buhsdv/AD9850_DDS/README.md

# Welcome to the AD9850 DDS generator

Hi! This project is used to build a **DDS frequency generator** out of a **Arduino yun** and a **AD9850** frequency module.

# Arduino program
The arduino program has everything in it to use it right away.

# Remote program

## Java version
The build version need JRE 17. If you want to use an other JRE, you can build the source with the JDK you want.
