buhsdv/AD9850_DDS/Dokumentation/01_VP_DDS_KrauseFischer_THOWL_Praesentation.pdf

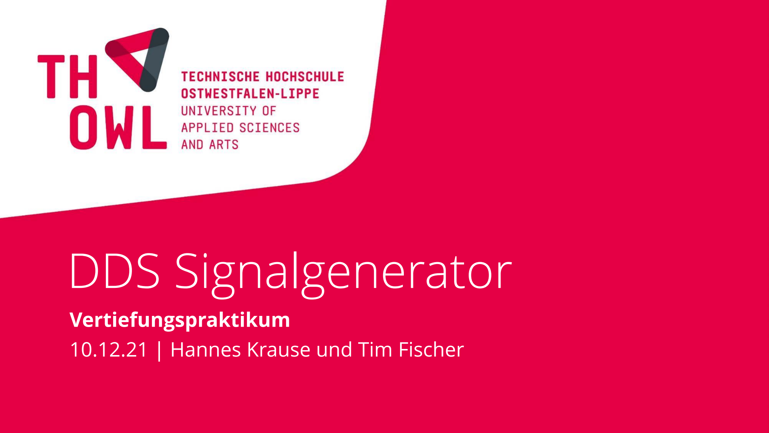
[picture p38: page 1]

# DDS Signalgenerator

Vertiefungspraktikum
10.12.21 | Hannes Krause und Tim Fischer

Datum | Name

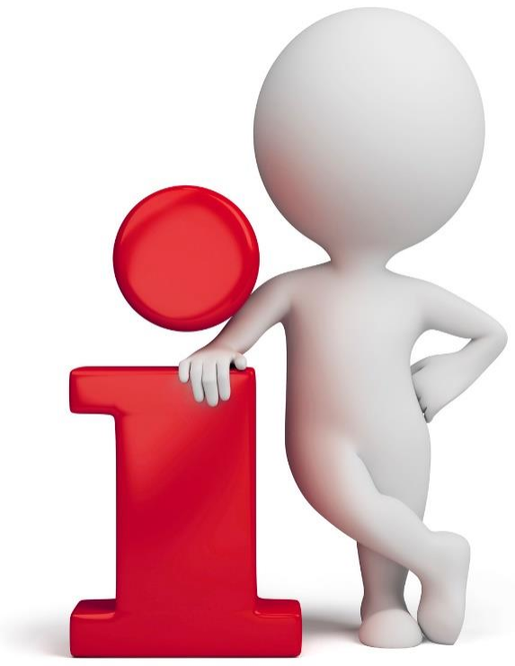
[picture p39: figure]

◼ Aufgabenstellung & Herausforderungen ◼ Hintergrundwissen
◼ Hardware
◼ Aufbau
◼ Arduino Programm
◼ Remote Programm
◼ Vorführung
◼ Messung und Fehleranalyse ◼ Ausblick
◼ Quellen

# Überblick

10.12.21 | Hannes Krause und Tim Fischer

# Aufgabenstellung

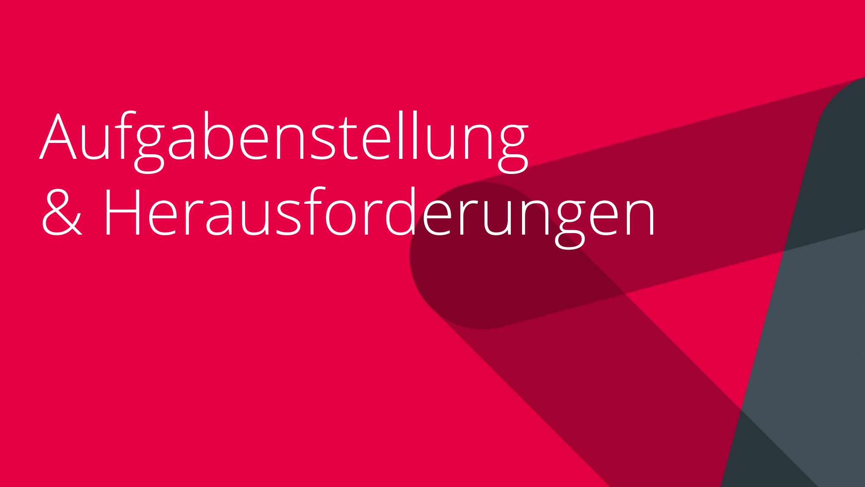
[picture p40: page 3]

# & Herausforderungen

# Aufgabenstellung

◼ Softwareentwurf DDS-Generator

◼ Festfrequenz

◼ Lineares & logarithmisches Wobbeln

◼ Einstellung aller Frequenzen in 10Hz-Schritten

◼ Menü

◼ Fernsteuerung über PC

# Herausforderungen

◼ Display mit zwei Zeilen stellt hohe Anforderungen an Menü

◼ Begrenzte Eingabemöglichkeit (Rotary Encoder + 3 Taster)

◼ Anforderung von linearem und logarithmischem Frequenzlauf

# Hintergrundwissen

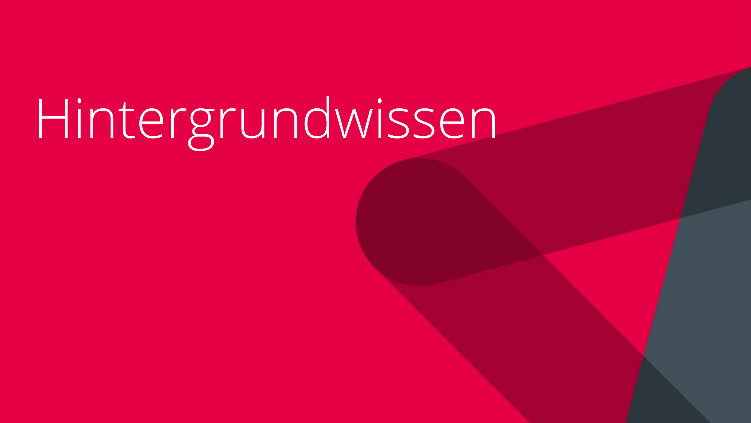
[picture p41: page 6]

# Was ist ein DDS-Generator?

◼ DDS = Direct Digital Synthesis/Direct Digital Synthesizer

◼ Verfahren zur Erzeugung analoger Wellenformen

◼ Digital erzeugtes, zeitveränderliches Signal mittels D/A-Wandler in analoge Ausgangsgröße umgewandelt

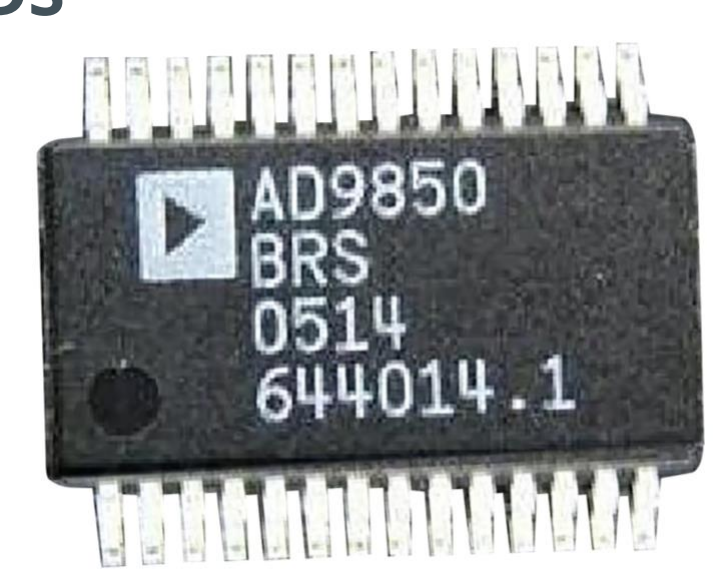
[picture p42: figure]

◼ DDS & D/A-Wandler auf einem Chip: Complete DDS

◼ Referenztakt & Steuerwort benötigt

# Was ist ein DDS-Generator?

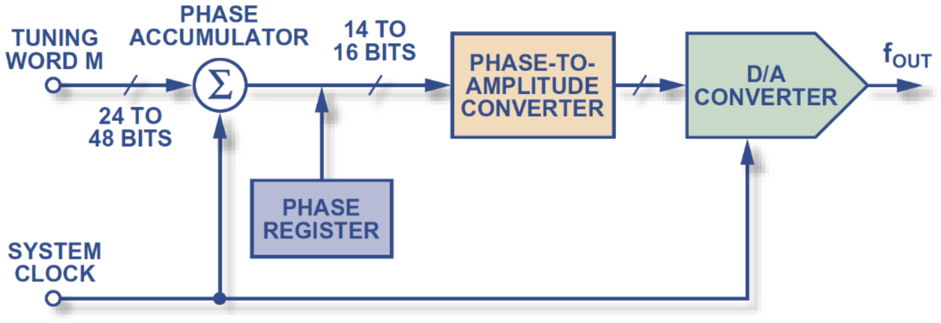
[picture p43: figure]

# Was ist ein DDS-Generator?

◼ Akkumulator addiert pro Taktzyklus Wert des Steuerworts auf aktuellen Akkumulator-Wert
◼ Bei Überlauf Rücksetzen auf Null

◼ →sägezahnförmiger Verlauf des Wertes

◼ →kann als diskretes Maß für Phasenwinkel eines Sinus betrachtet werden

# Was ist ein DDS-Generator?

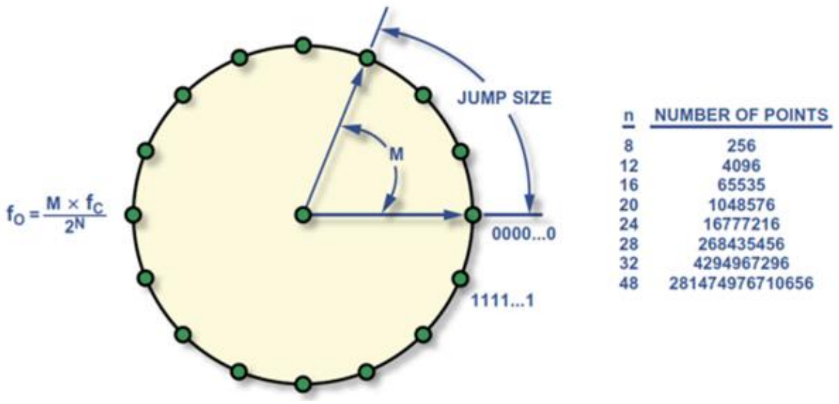
[picture p44: figure]

# Was ist ein DDS-Generator?

◼ fout =

M∗fc
2

n
◼ Nach Nyquist-Shannon gilt: fout,max =

fc
2
◼ tatsächliche Maximalfrequenz deutlich kleiner, da dann bessere Signalgüte & Weiterverarbeitung möglich

◼ Zuordnung von Funktionswerten zu Phasenwerten über Lookup-Table oder Algorithmen (z.B. CORDIC)

◼ Erzeugen des quasi-zeitkontinuierlichen , sinusförmigen Ausgangssignals durch den D/A-Wandler

# Was ist ein DDS-Generator?

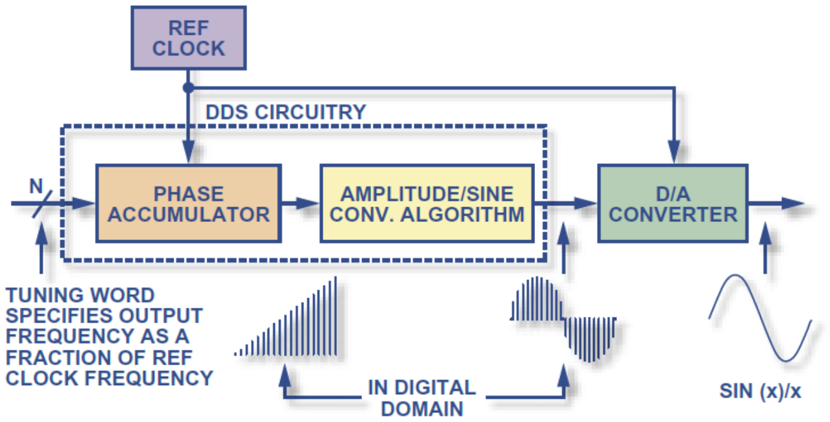
[picture p45: figure]

# Was ist ein DDS-Generator?

◼ Kompakte & kostengünstige Herstellung

◼ Vollst. digital programmierbar → simple Hardware

◼ Frequenzauflösung im Microhertz-Bereich

◼ Extrem schnelle, exakte Frequenzänderung

◼ Qualitativ hochwertiges Ausgangssignal mit großem Frequenzbereich

◼ Geringer Leistungsbedarf

# Frequenzlauf

◼ Auch Sweep, Chirp oder Wobbel genannt

◼ Wechselsignal konstanter Amplitude

◼ Frequenz ändert sich zeitlich periodisch zwischen Start- und Endwert
◼ Änderung in unterschiedlicher Form möglich

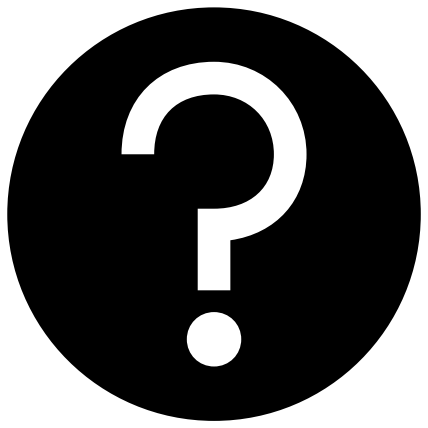
[picture p46: figure]
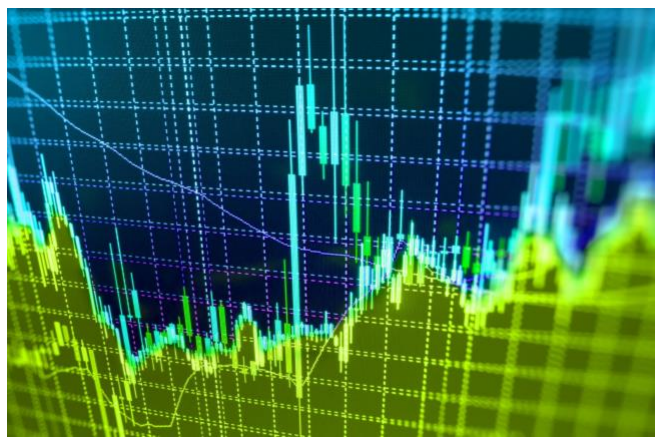
[picture p47: figure]
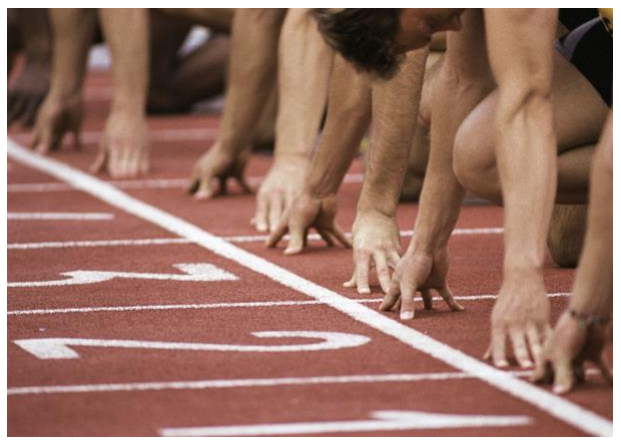
[picture p48: figure]

# Linearer Frequenzlauf

◼ Lineare Frequenzänderung vom Start- zum Endwert: f t = ct + f0
◼ Mit Frequenzänderung c:

c =

f1 − f0
T
◼ Integration der Frequenz liefert Phase: φ t = φ0 + 2π න

0

t
f τ dτ

◼ Zeitfunktion des linear gesweepten Signals:
x t = sin | φ t | = sin | φ0 + 2π

c
2

∗ t

2 + f0t

# Linearer Frequenzlauf

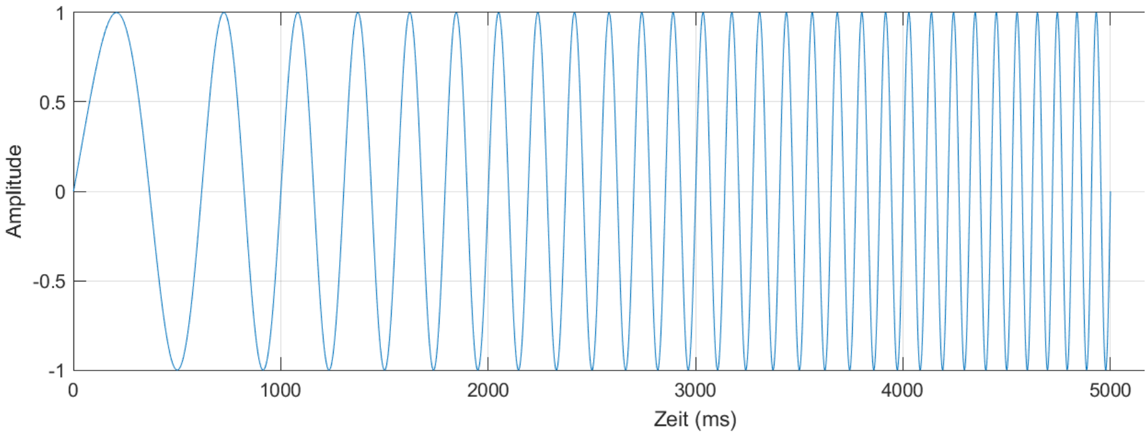
[picture p49: figure]

# Logarithmischer Frequenzlauf

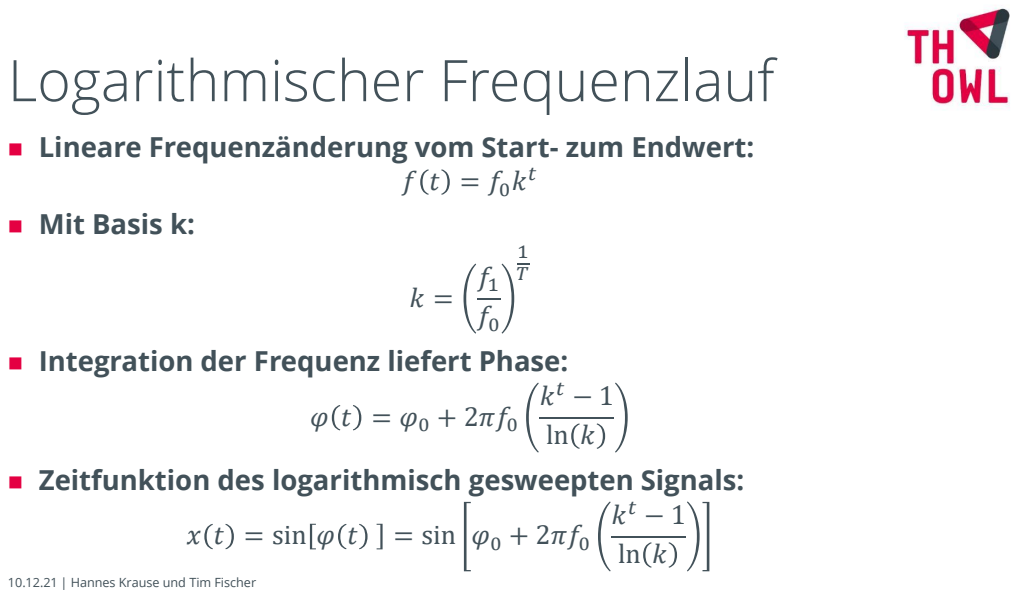
[picture p50: page 17]
◼ Mit Basis k:; x t = sin; = sin

◼ Lineare Frequenzänderung vom Start- zum Endwert:

◼ Integration der Frequenz liefert Phase:

◼ Zeitfunktion des logarithmisch gesweepten Signals:

# Logarithmischer Frequenzlauf

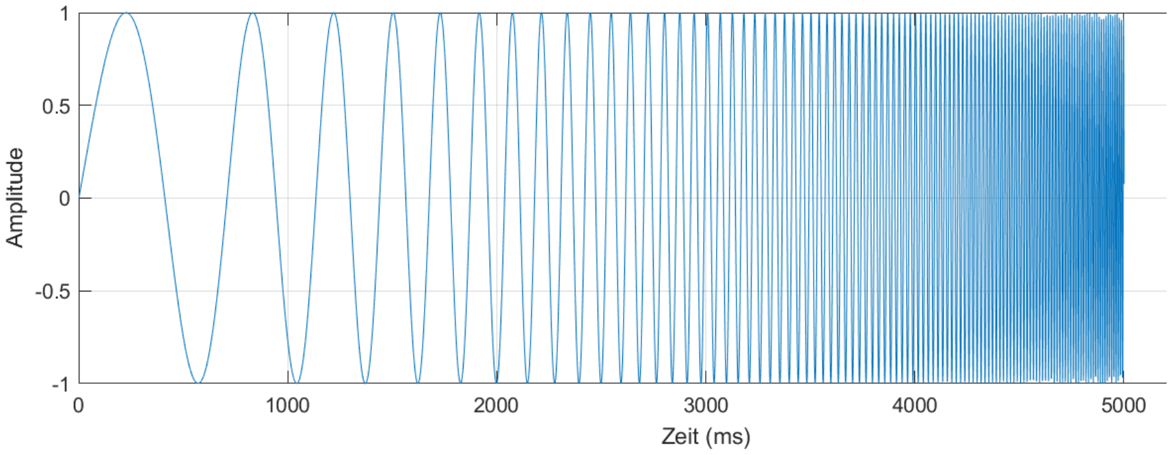
[picture p51: figure]

# Verwendete Hardware

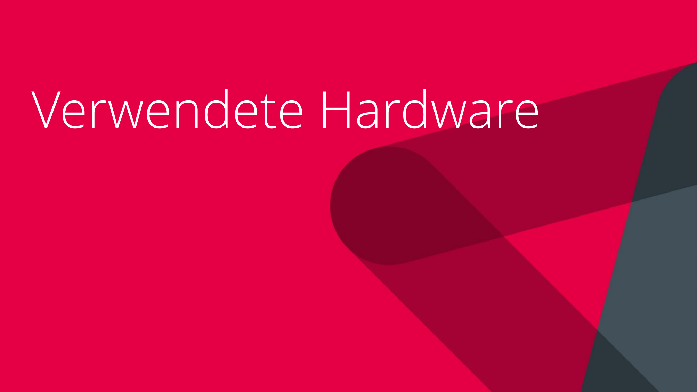
[picture p52: page 19]

# Arduino Yun

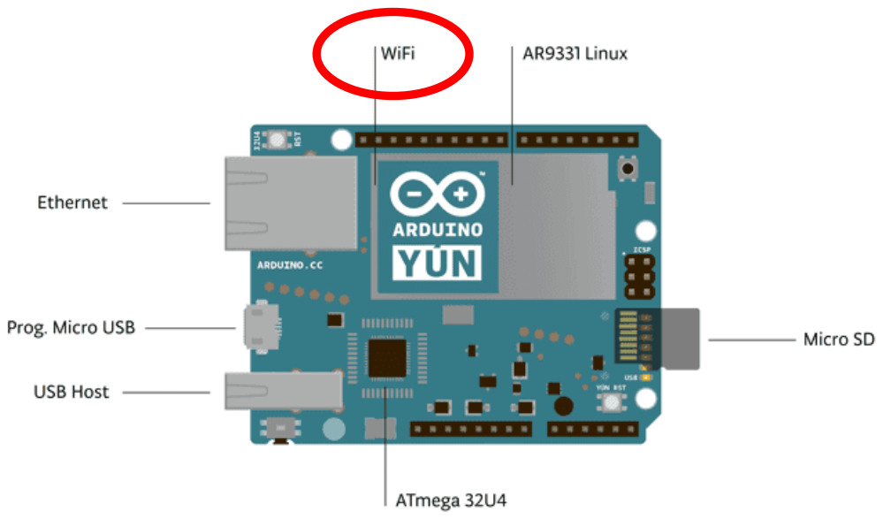
[picture p53: figure]

# Arduino Yun

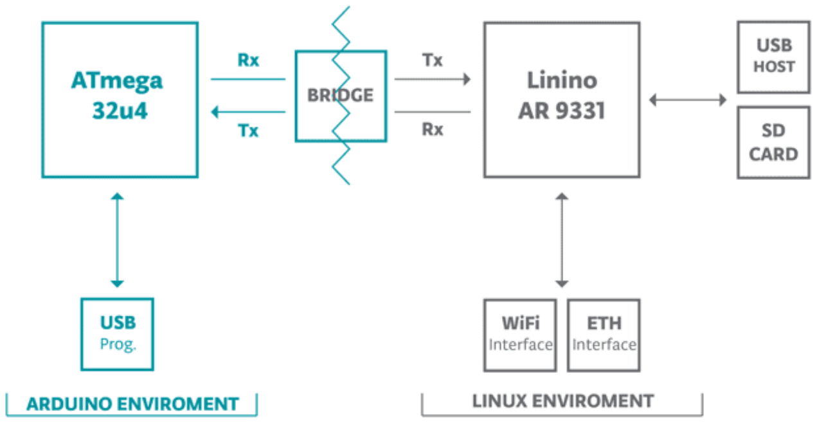
[picture p54: figure]

# ADS9850 (HC-SR08)

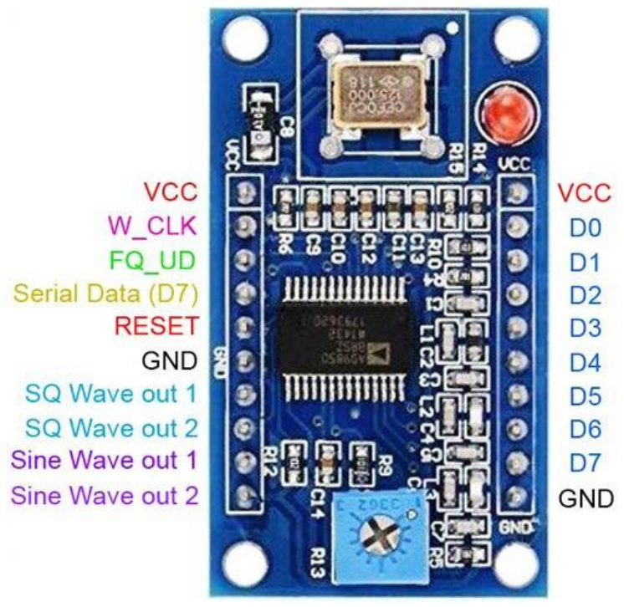
[picture p55: figure]

# ADS9850 (HC-SR08)

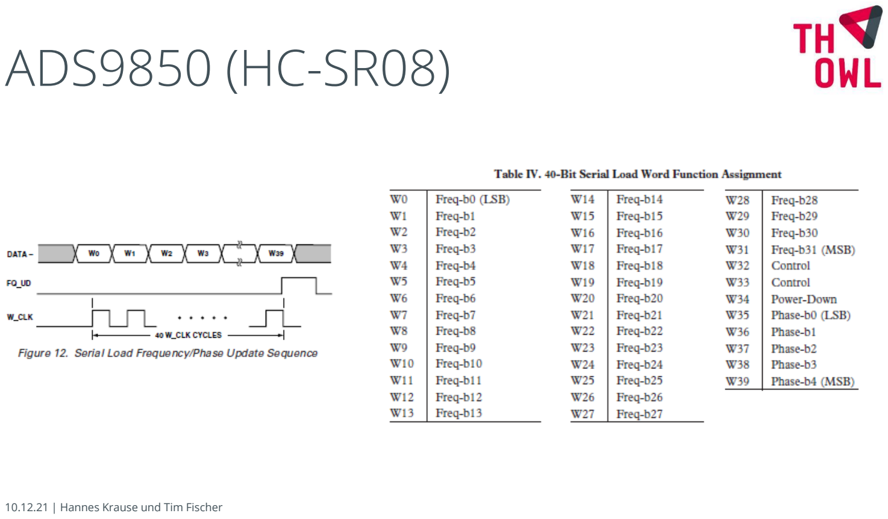
[picture p56: page 23]

# LCD mit HD44780-Controller

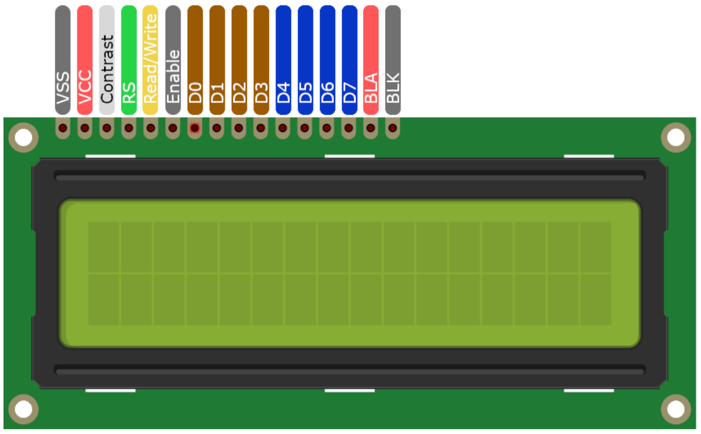
[picture p57: figure]

# Drehinkrementalgeber

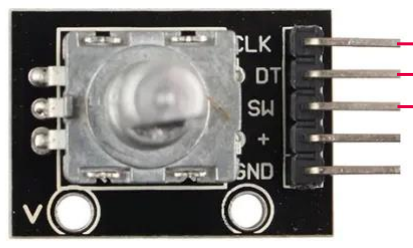
[picture p58: figure]

Output B
Output A
Switch

# Drehinkrementalgeber

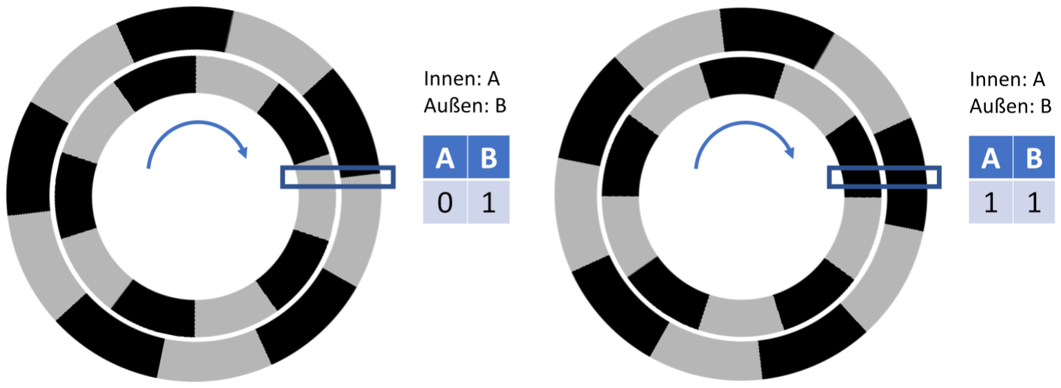
[picture p59: figure]

# Der Aufbau

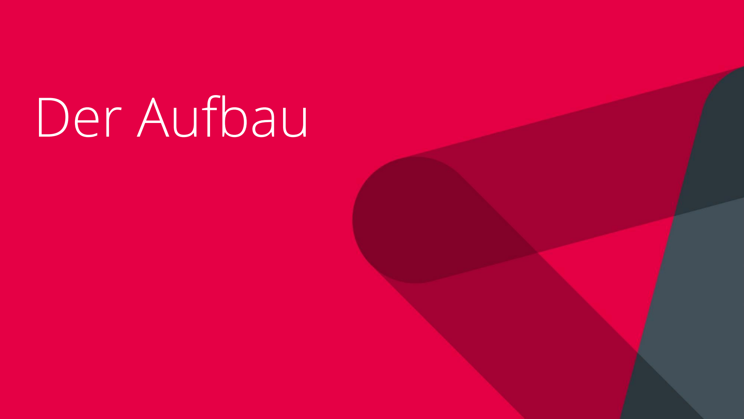
[picture p60: page 27]

# Der Aufbau

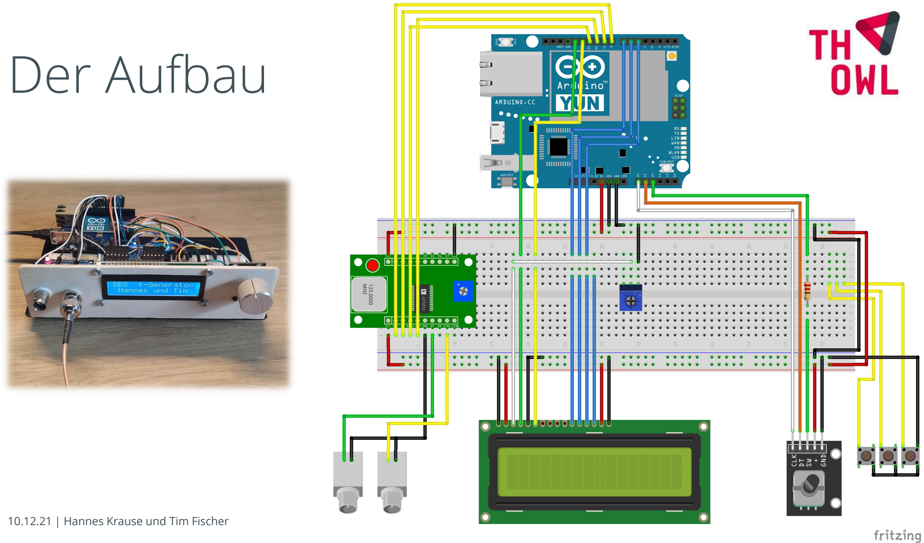
[picture p61: page 28]

# Das Arduino-Programm

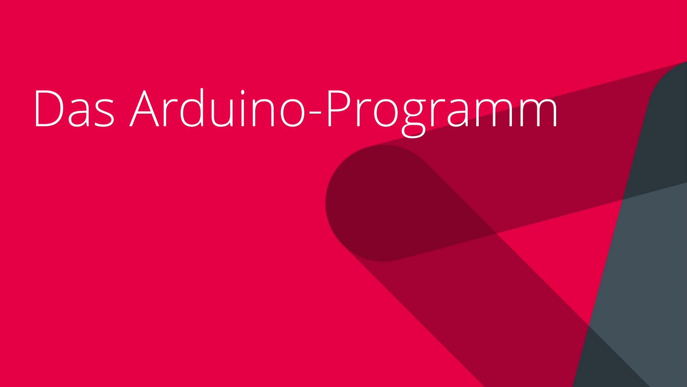
[picture p62: page 29]

# Menüstruktur

◼ Nutzen der „LCD-Simple Menu Library“

◼ Strukturierung durch verschiedene Menüebenen / Untermenüs

◼ Unterschiedlich strukturierte Menüpunkte für unterschiedliche Aufgaben:

# Menüstruktur

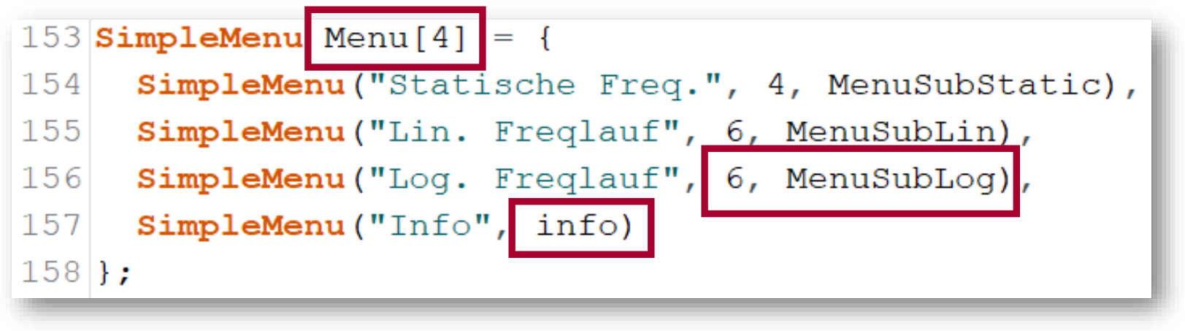
[picture p63: figure]

# Menüstruktur

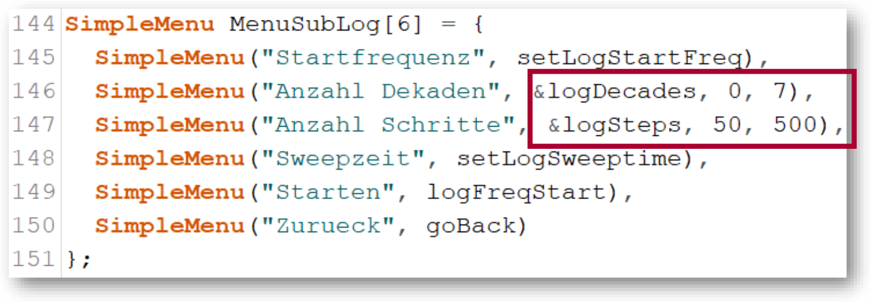
[picture p64: figure]

# Menüstruktur

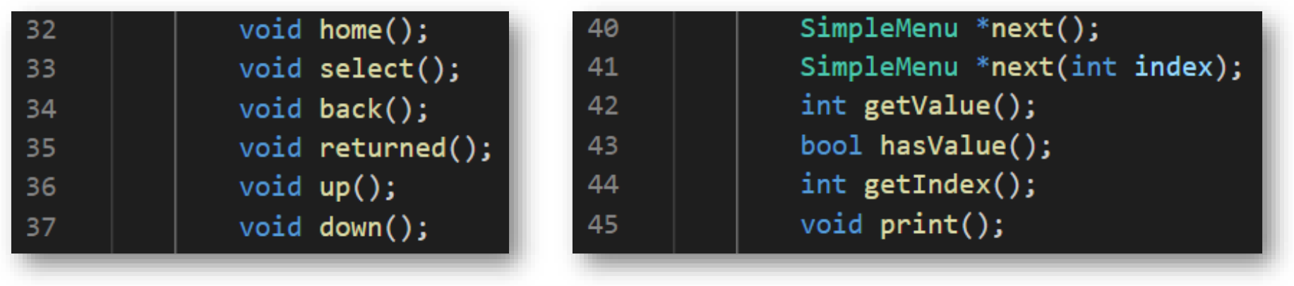
[picture p65: figure]

# Programmablauf

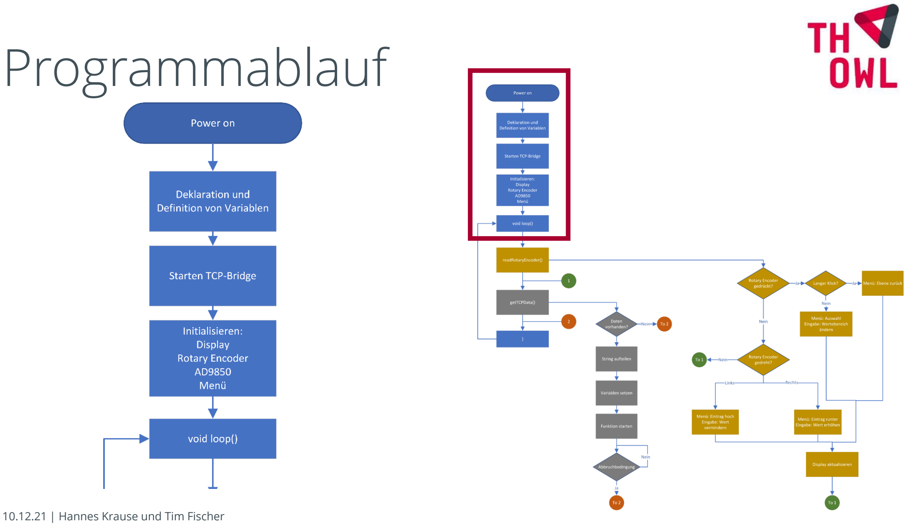
[picture p66: page 34]

# Programmablauf

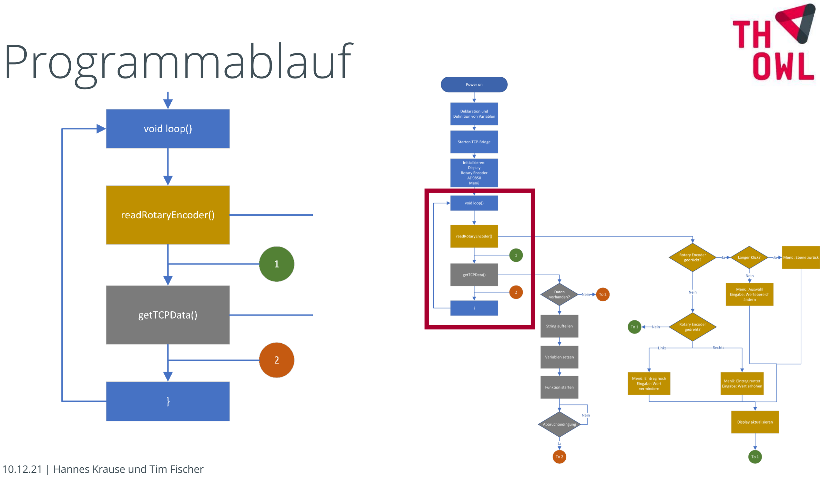
[picture p67: page 35]

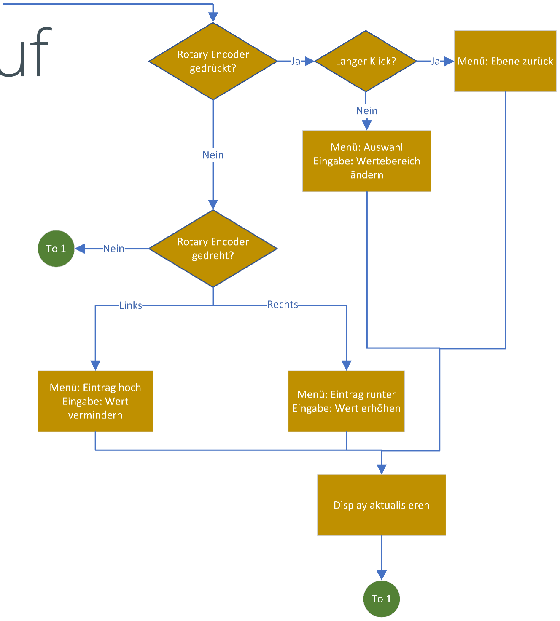
[picture p68: figure]

# Programmablauf

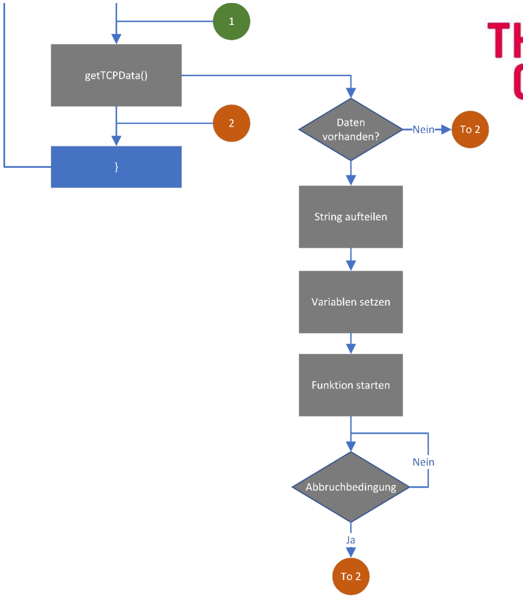
[picture p69: figure]

# Programmablauf

# Ausgewählte Funktionen

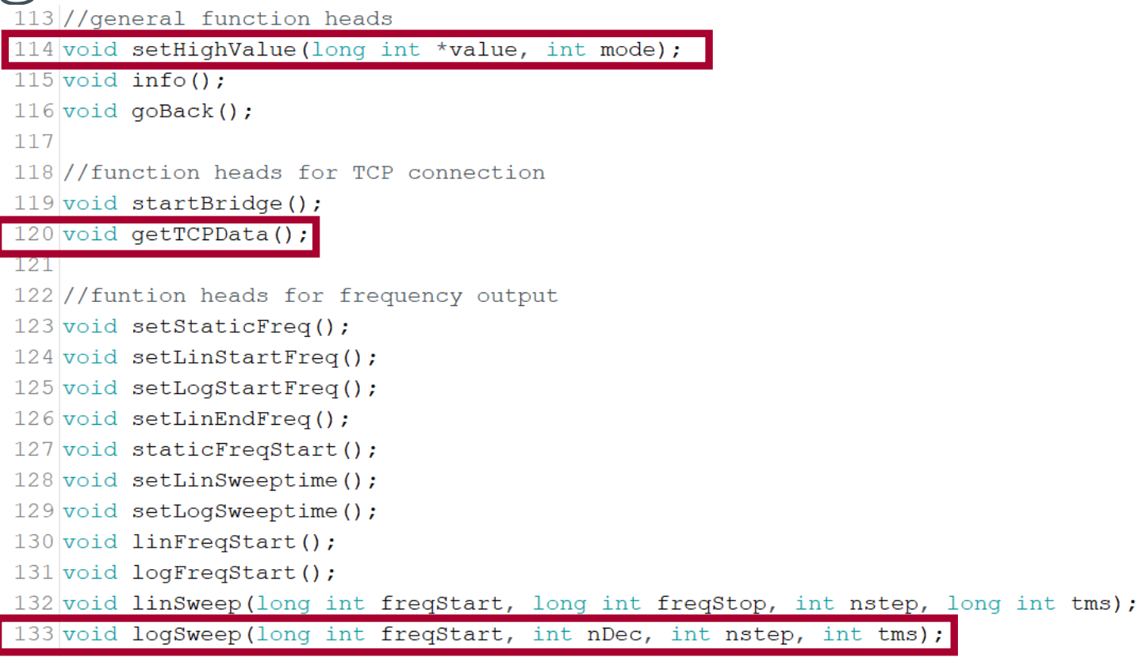
[picture p70: figure]

# setHighValue

◼ Zur Einstellung sämtlicher Variablenwerte

◼ Adressübergabe der zu ändernden Variable als Pointer ◼ Übergabe Eingabeformat als „mode“

# setHighValue

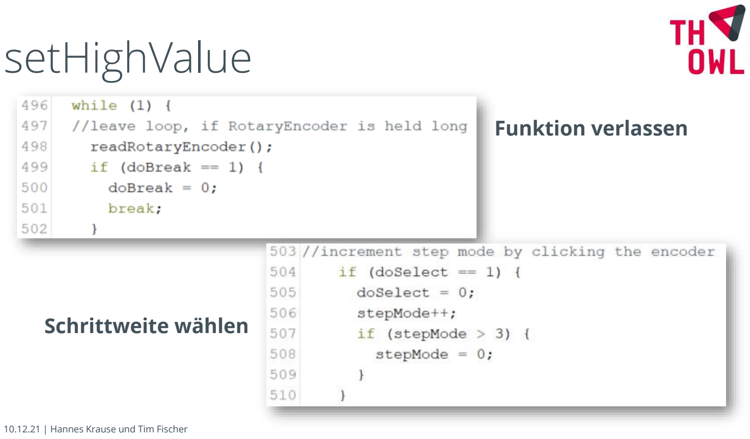
[picture p71: page 40]

Funktion verlassen

Schrittweite wählen

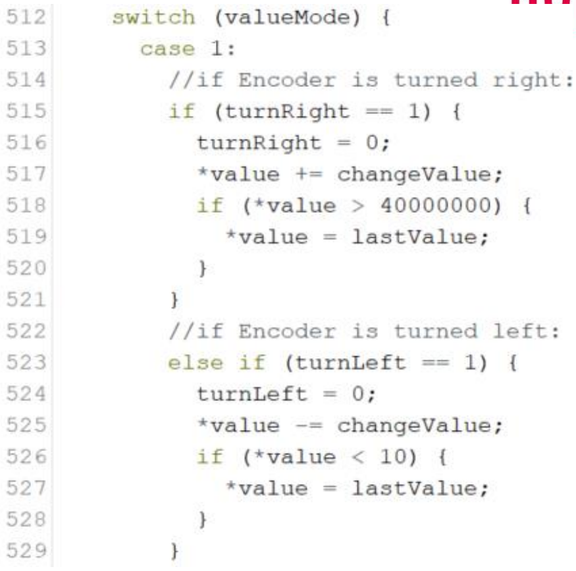
[picture p72: figure]

# setHighValue

◼ Unterscheidung, ob Frequenz oder Zeit

◼ Inkrementieren bzw.
Dekrementieren des
Variablenwertes

◼ Festlegen der Grenzwerte

# setHighValue

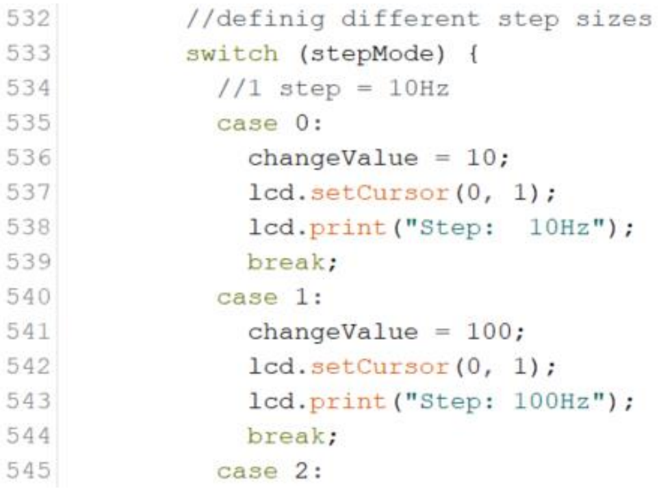
[picture p73: figure]

◼ Festlegen der Schrittweite

◼ 10Hz, 100Hz, 10kHz, 1MHz

◼ 10ms, 100ms, 1s, 10s

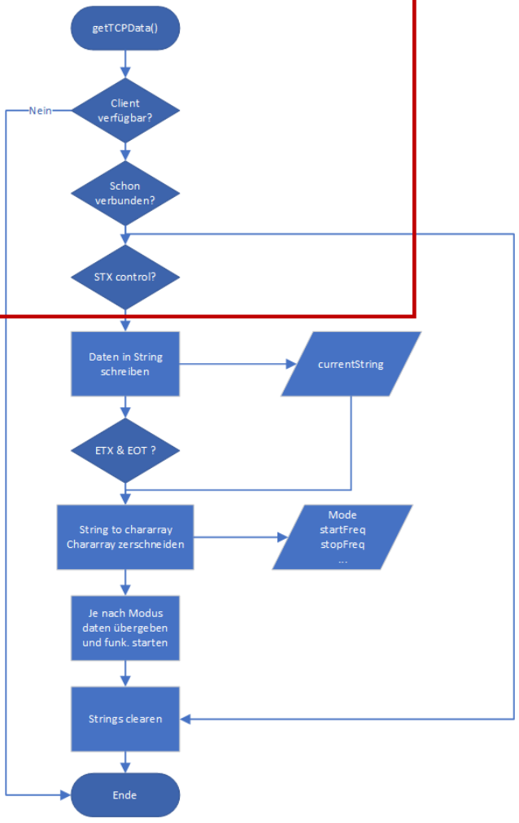
[picture p74: figure]

# getTCPData()

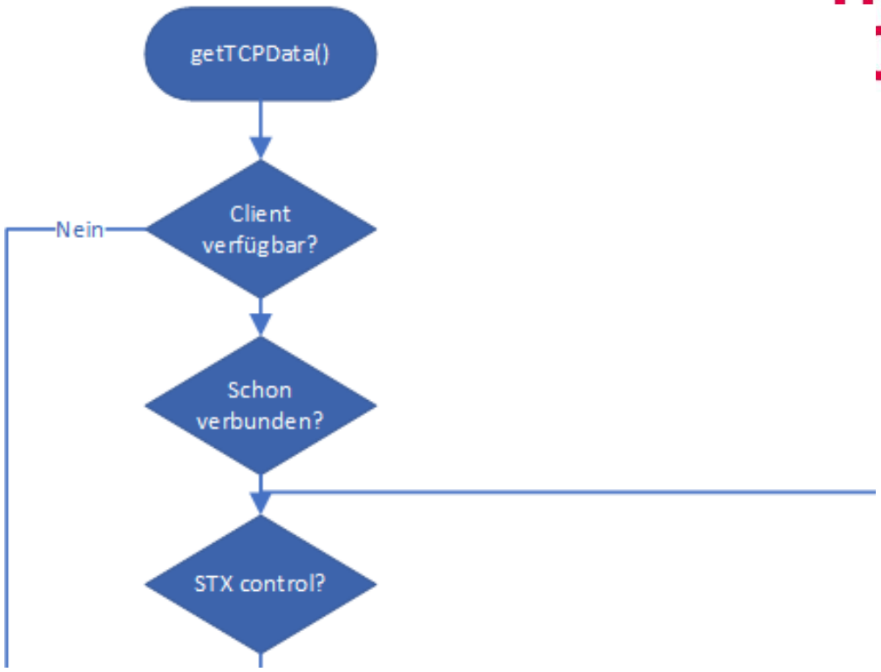
[picture p75: figure]

# getTCPData()

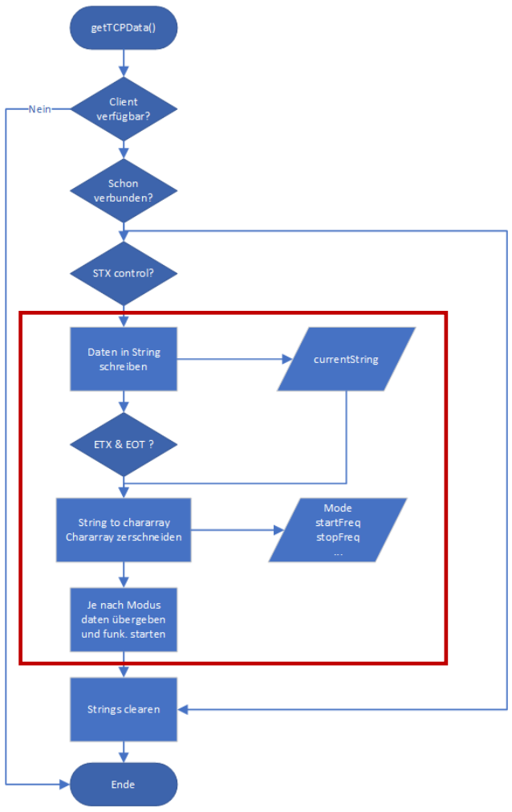
[picture p76: figure]

# getTCPData()

# getTCPData()

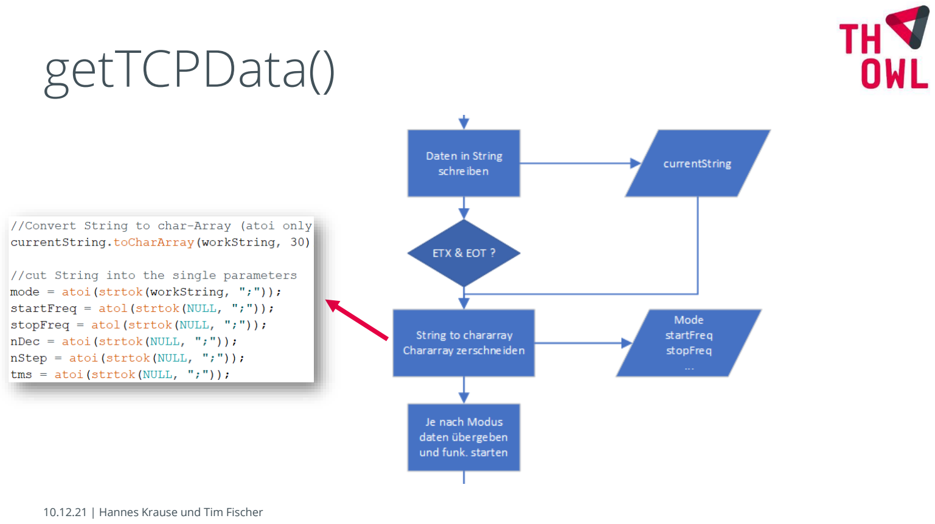
[picture p77: page 46]

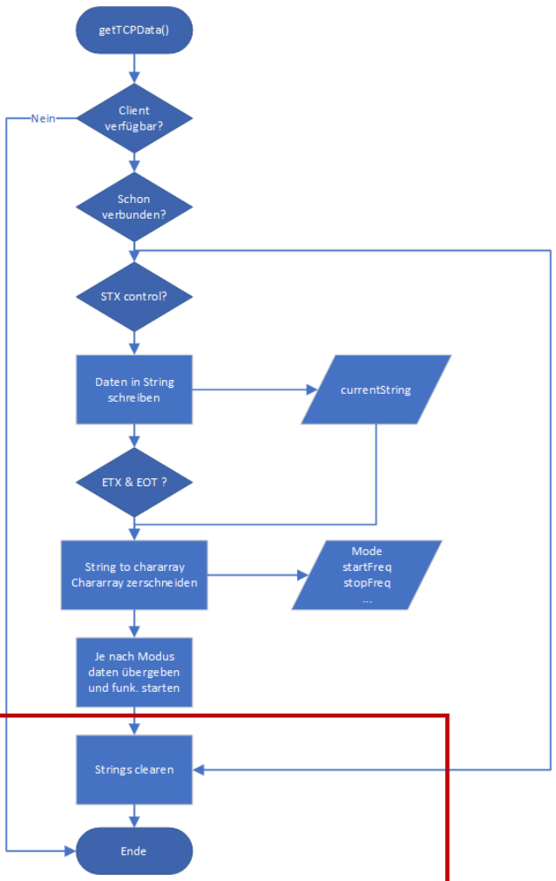
[picture p78: figure]

# getTCPData()

# getTCPData()

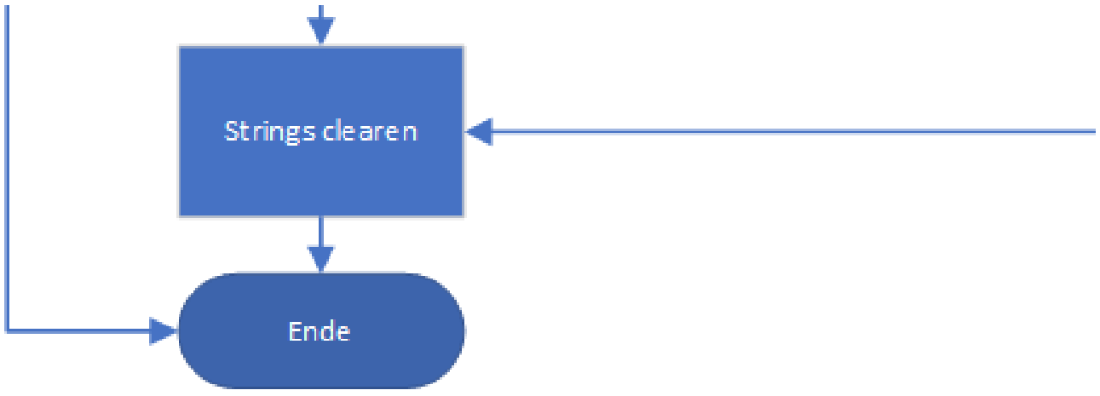
[picture p79: figure]

# logSweep

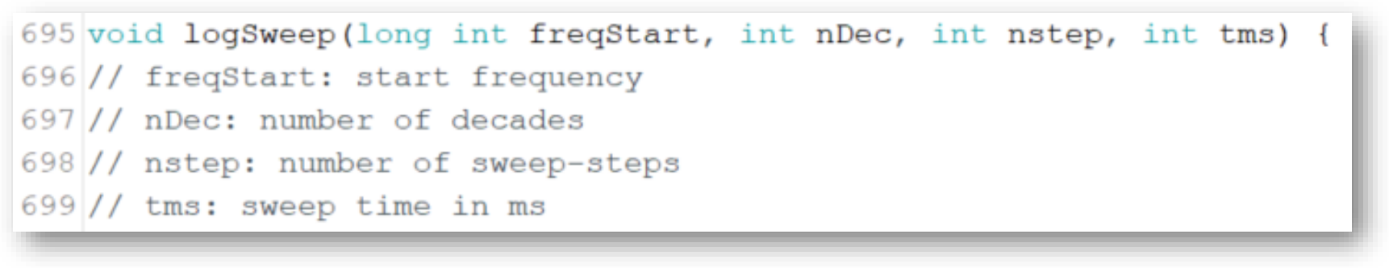
[picture p80: figure]

◼ Berechnung eines exponentiellen Frequenzverlaufs, Übergabe an den DDS

◼ Ausgabe aller wichtigen Parameter auf dem LCD

# logSweep

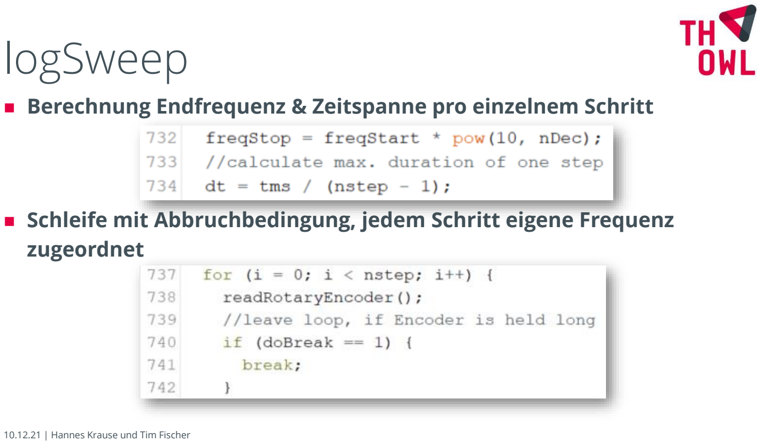
[picture p81: page 50]

◼ Berechnung Endfrequenz & Zeitspanne pro einzelnem Schritt

◼ Schleife mit Abbruchbedingung, jedem Schritt eigene Frequenz zugeordnet

# logSweep

◼ Math. Funktion zur Modellierung eines exponentiellen Anstiegs mit bestimmter Schrittanzahl und Wertebereich:

y i = 2

log2 res ∗

i+1
nstep − 1
- res = Wertebereich von y → wenn res = 65536 (16 Bit), dann kann y alle Werte zwischen 0 und 65535 annehmen
- i = Zählervariable, pro Schleifendurchlauf inkrementiert
- An den DDS übergebene Frequenz in Abhängigkeit von i:

freq i = freqStart +

freqStop − freqStart
res − 1

∗ y i

# logSweep

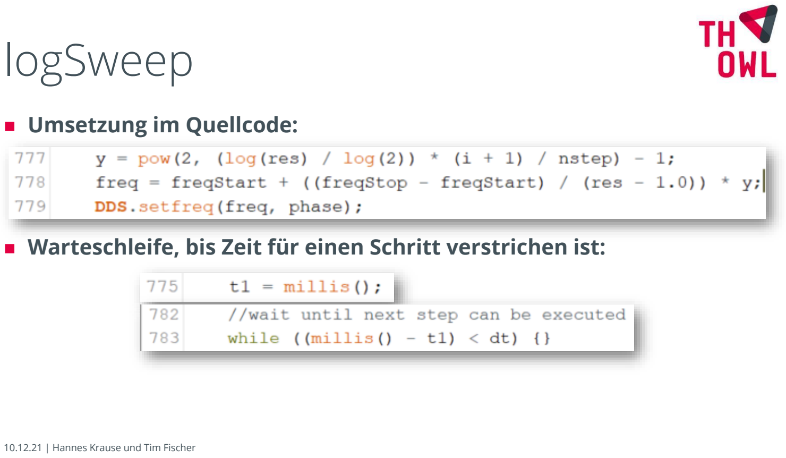
[picture p82: page 52]

◼ Umsetzung im Quellcode:

◼ Warteschleife, bis Zeit für einen Schritt verstrichen ist:

# logSweep

◼ Wechselnde Displayausgabe:

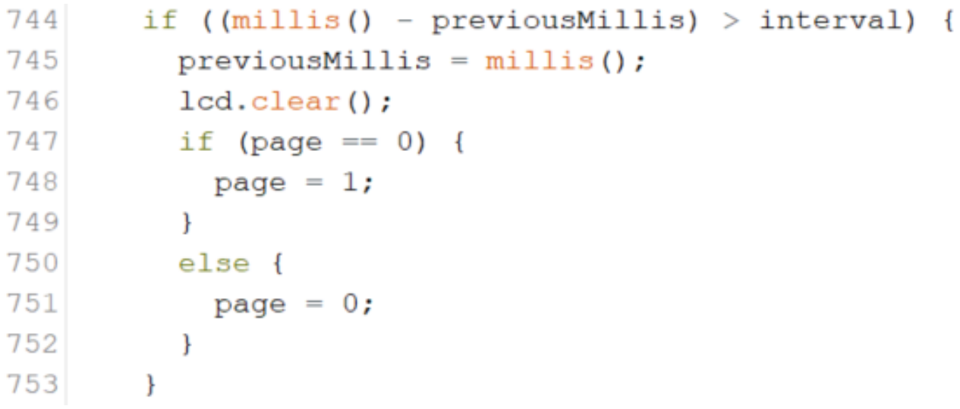
[picture p83: figure]

# Das remote Programm

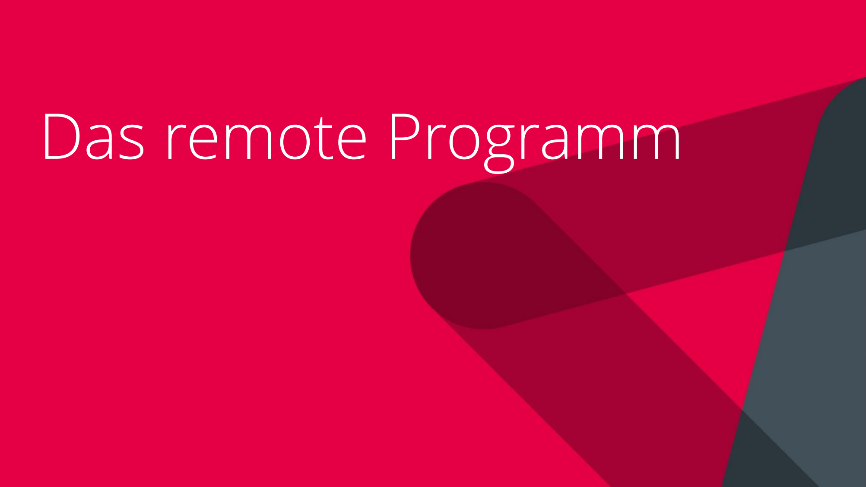
[picture p84: page 54]

# Klassen

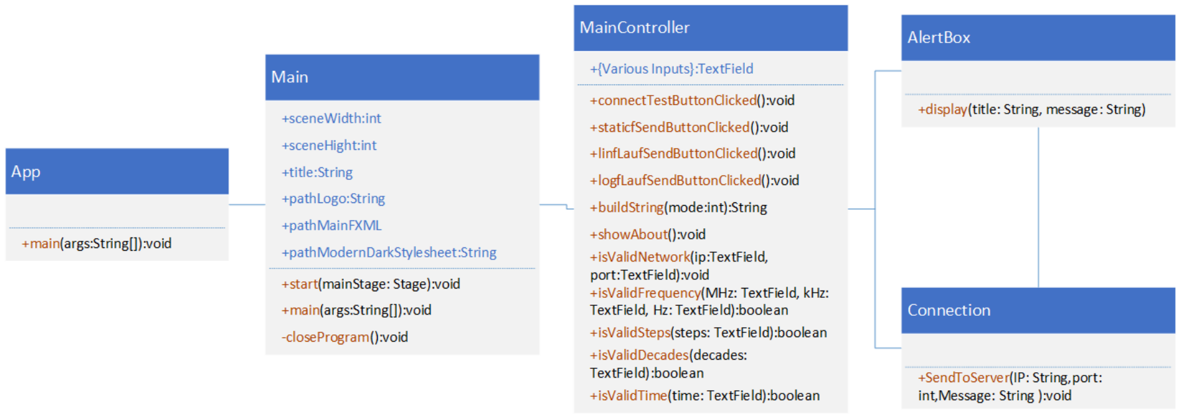
[picture p85: figure]

# JavaFX -> FXML

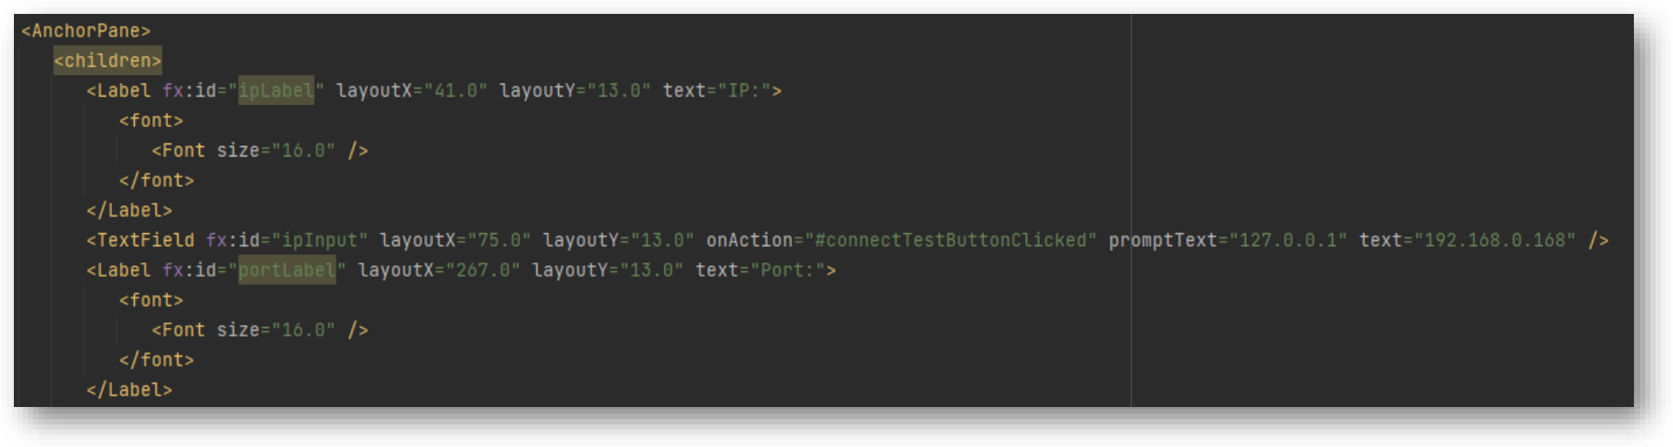
[picture p86: figure]

# JavaFX -> FXML

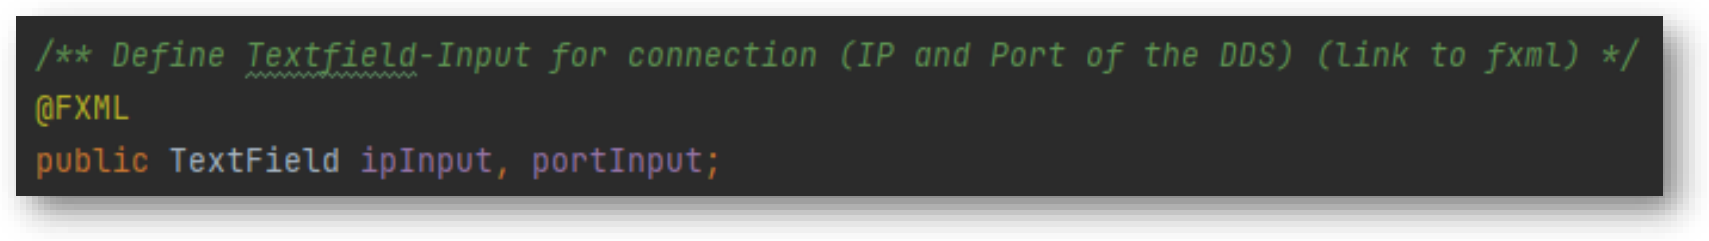
[picture p87: figure]

# Ausgewählte Funktionen

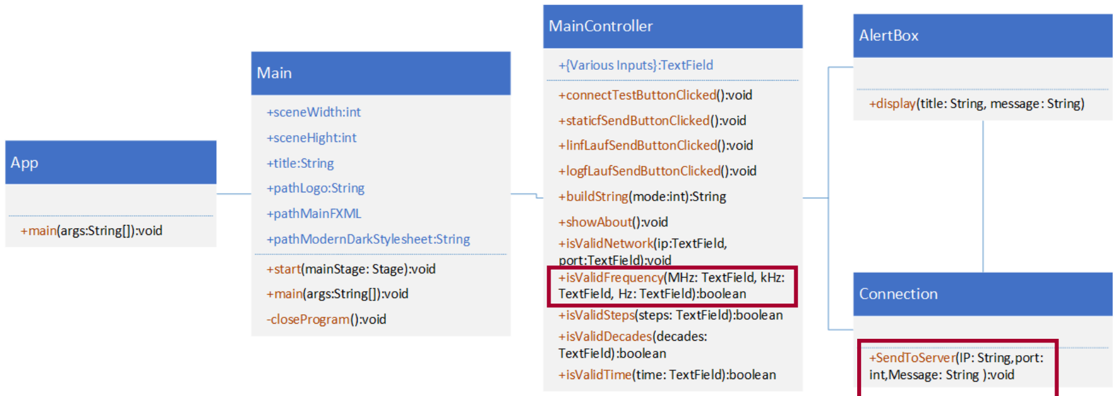
[picture p88: figure]

# sendToServer(…)

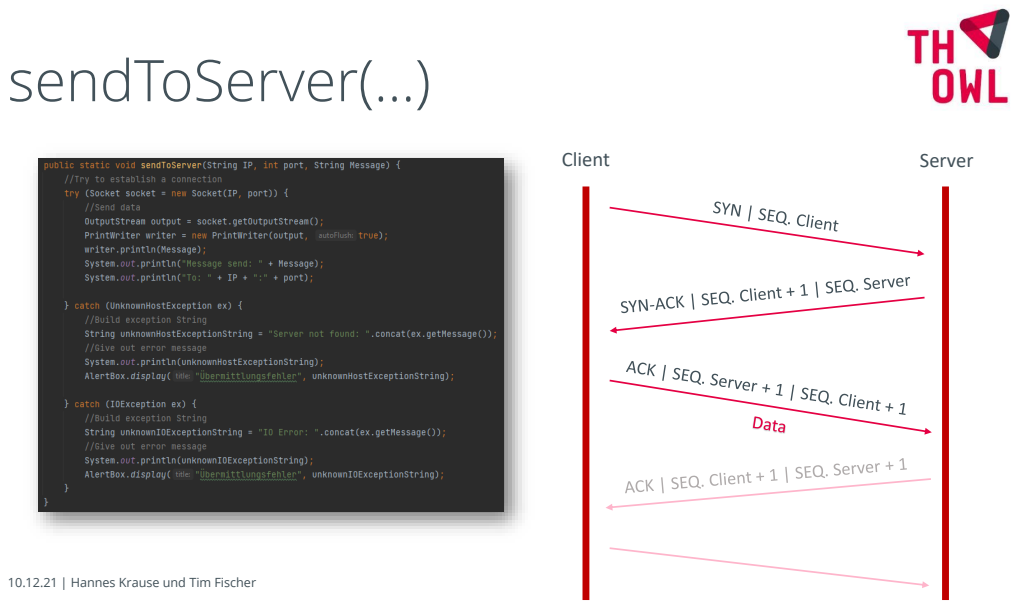
[picture p89: page 59]
Client; Server

# sendToServer(…)

# isValidFrequency(…)

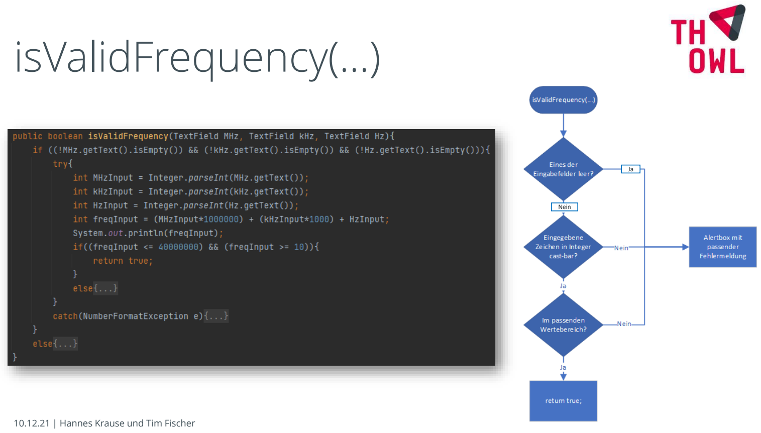
[picture p90: page 61]

Ja

Nein

# Vorführung

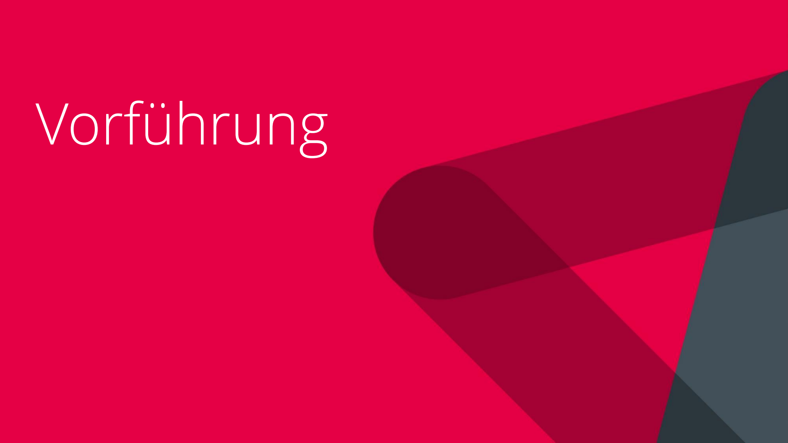
[picture p91: page 62]

# Messung und

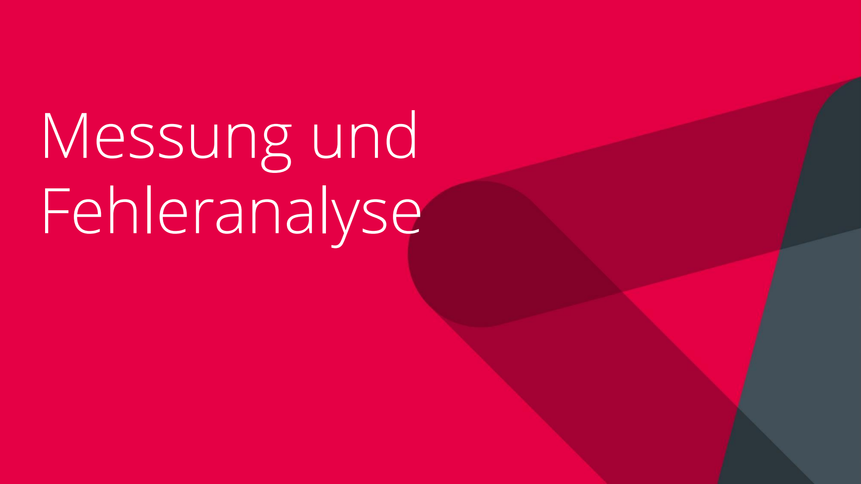
[picture p92: page 63]

# Fehleranalyse

# Frequenzmessung

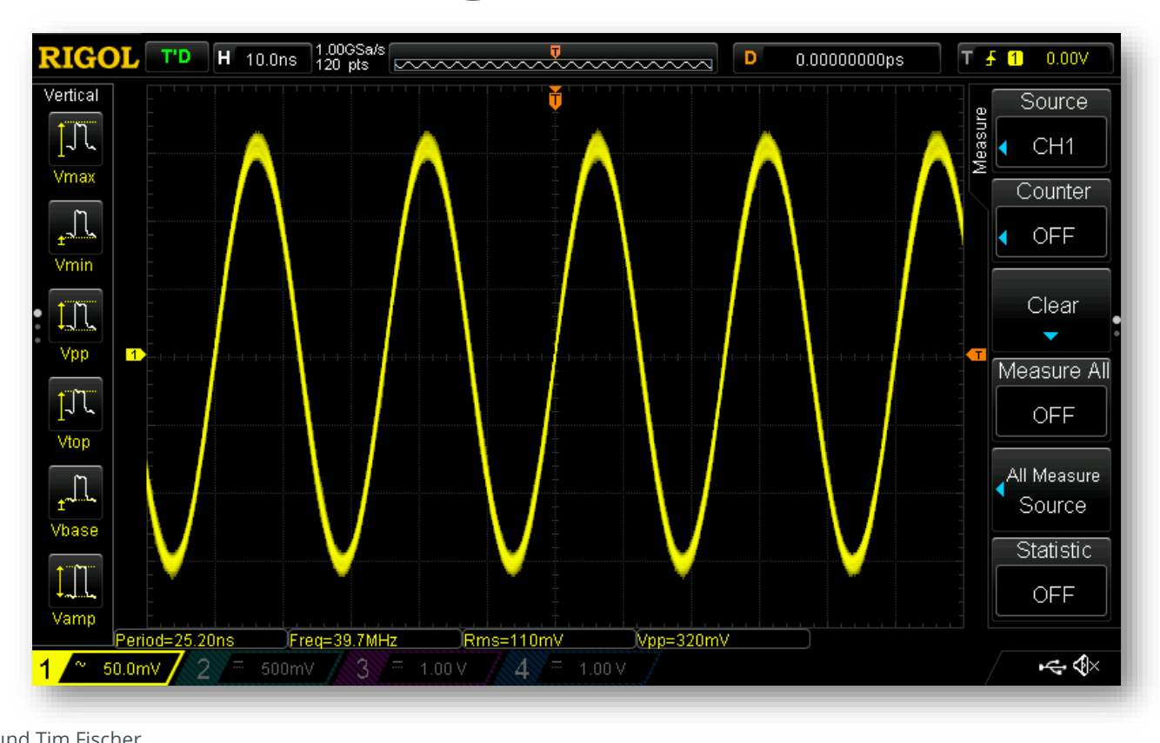
[picture p93: figure]

# FFT

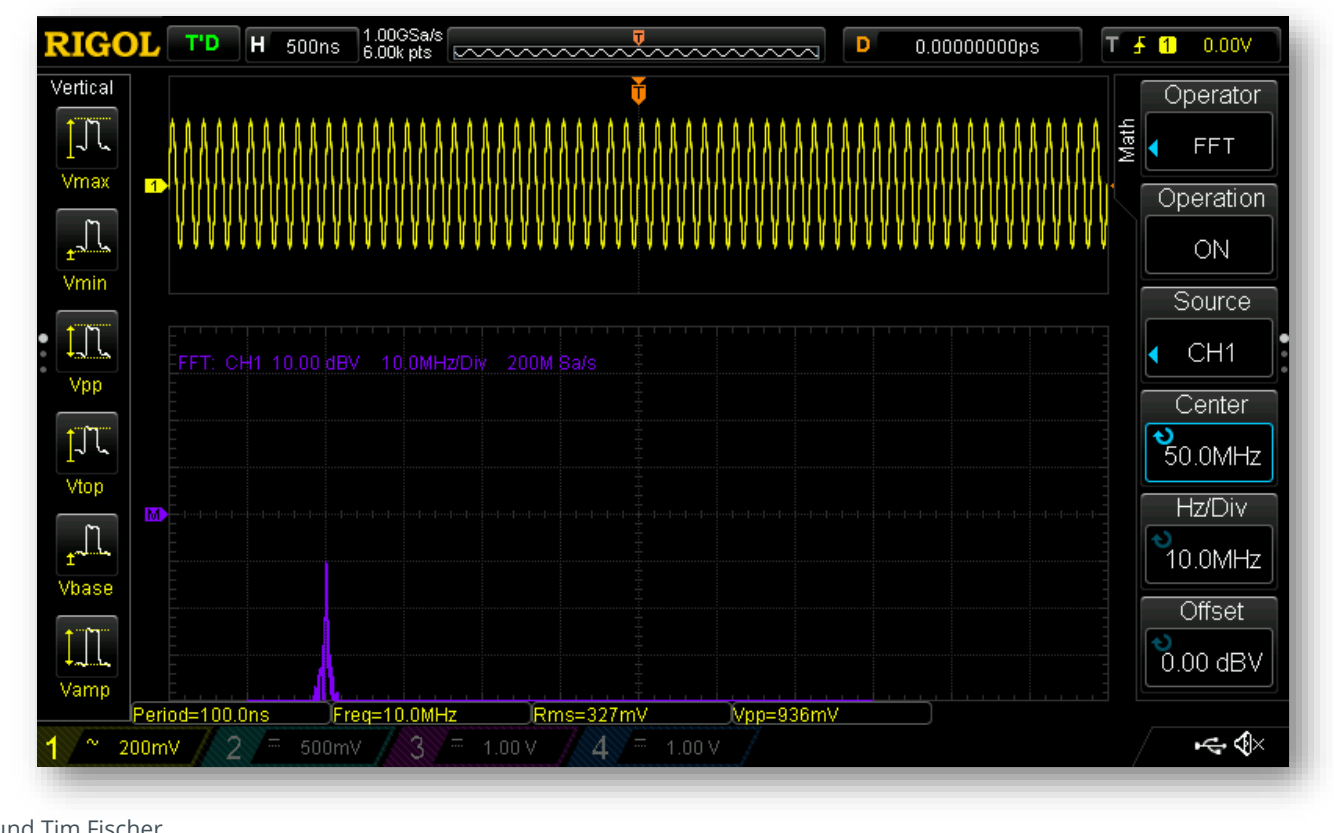
[picture p94: figure]

# Ausblick

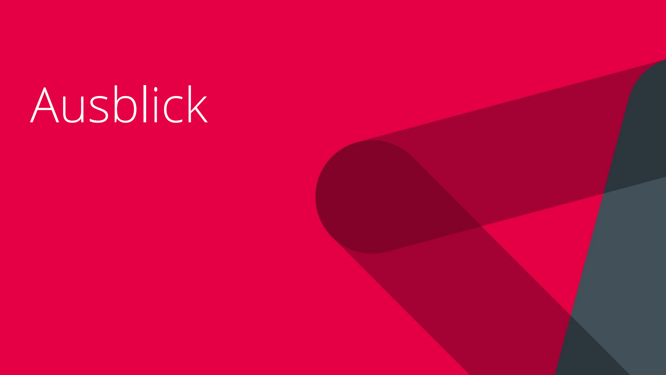
[picture p95: page 66]

# Ausblick

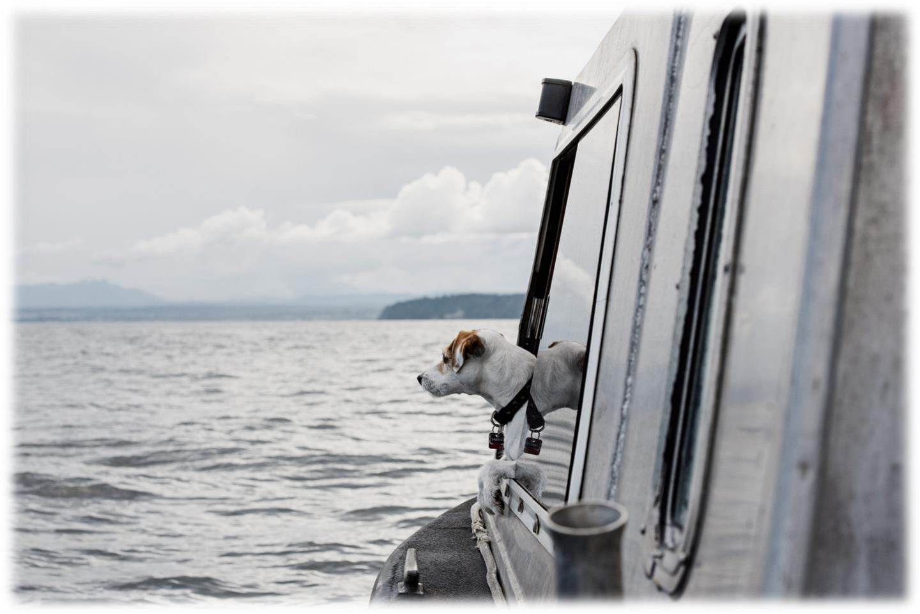
[picture p96: figure]

# Quellen

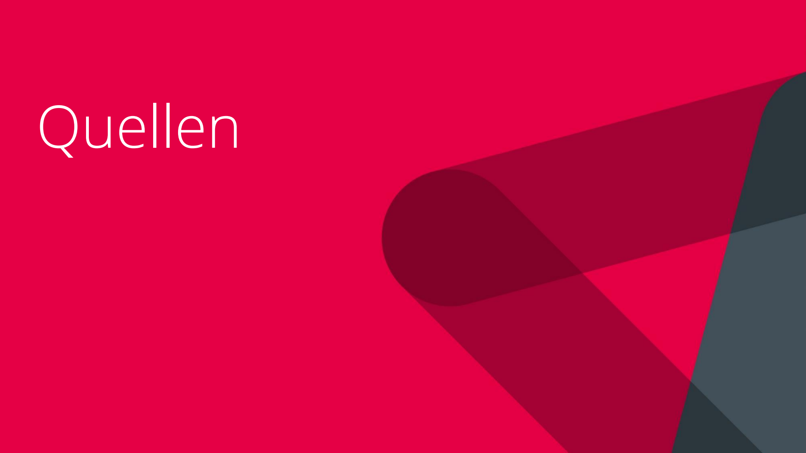
[picture p97: page 68]

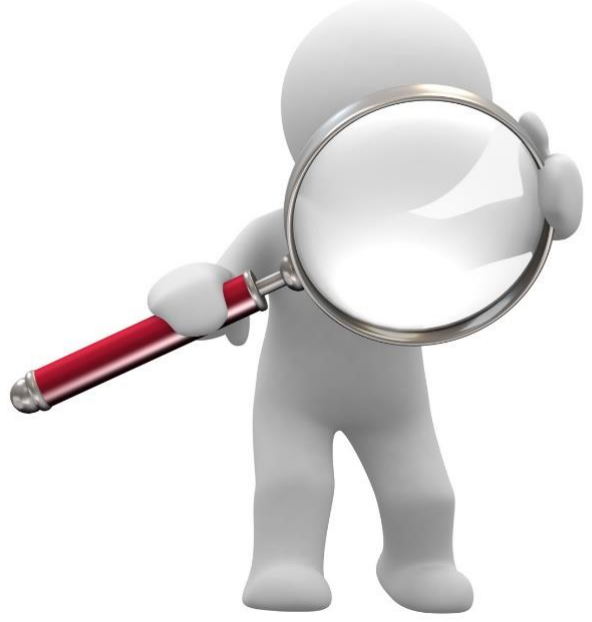
[picture p98: figure]

◼

Siehe Dokumentation

# Quellen

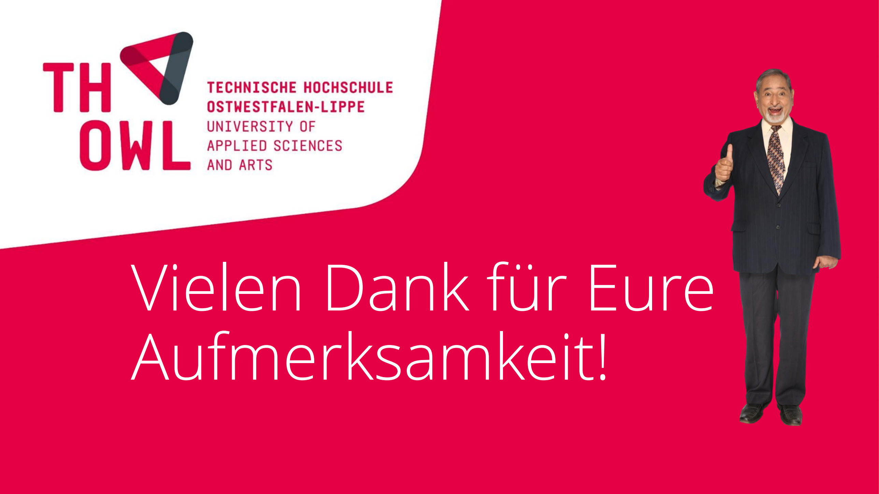
[picture p99: page 70]

# Vielen Dank für Eure Aufmerksamkeit!
