buhsdv/AD9850_DDS/Dokumentation/schematic/DDS_schematic.png

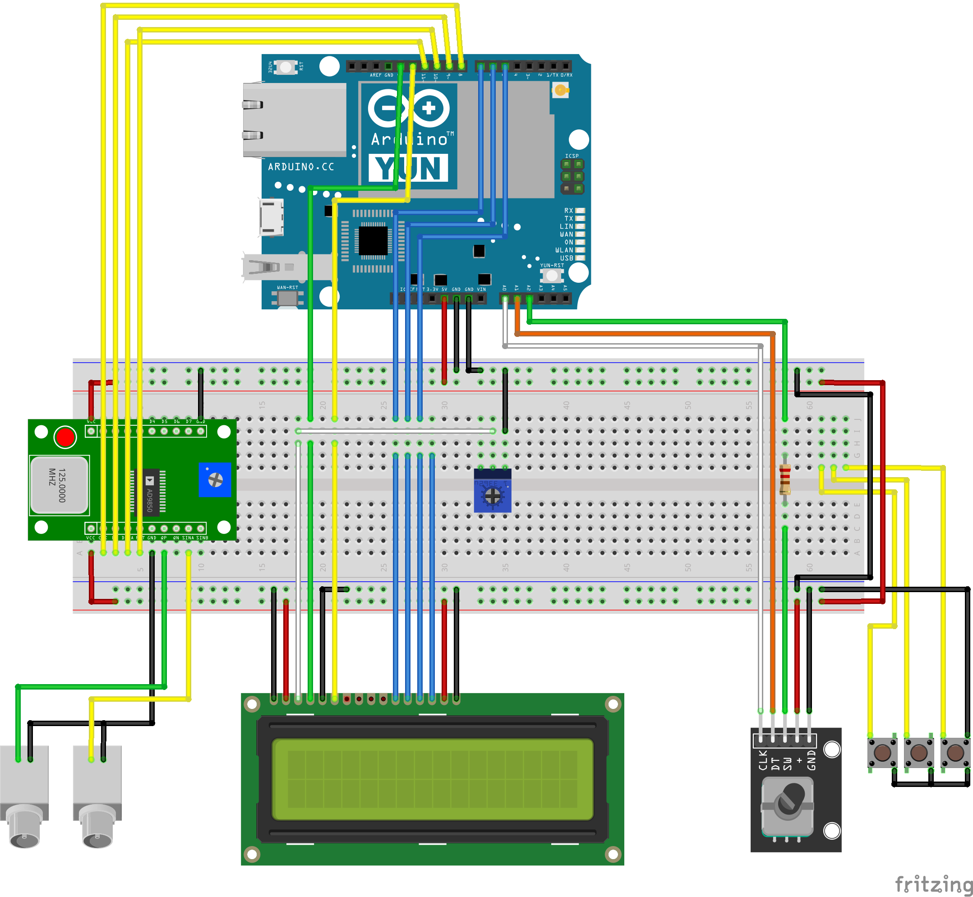
Dokumentation/schematic/DDS_schematic.png
